faster-light/18650_Spot_Welder/Spot_Welder/Src/main.c

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

/* Includes ------------------------------------------------------------------*/
#include "main.h"

/* USER CODE BEGIN Includes */

#include "ssd1306.h"
#include "fonts.h"


/* USER CODE END Includes */

I2C_HandleTypeDef hi2c1;

TIM_HandleTypeDef htim1;
TIM_HandleTypeDef htim2;

void SystemClock_Config(void);
static void MX_GPIO_Init(void);
static void MX_I2C1_Init(void);
static void MX_TIM1_Init(void);
static void MX_TIM2_Init(void);
/* USER CODE BEGIN 0 */

int zero_detect_flag = 0;								// Флаг прерывания детектора нуля
int zero_detect_flag_status = 0;				// Флаг прерываня в таймере 500 мс

char str[10];														// Буфер для отображения скважности и времени
char str2[10];

int encoder_A = 0;											// Переменная для обработки энкодера

int display_change_flag = 1;						// Флаг изменений	на дисплее
int select_value_by_encoder = 0;				// Выбор меню

int fire_flag = 0;											// Флаг сварки (включает число оставшихся циклов сварки)

int duty_cycle = 70;										// Скважность
int duration = 10;											// Продолжительность (Циклов сварки)


/*Callback по сравнению таймера (от 1.0 до 9.0 мс)*/
/*! �?спользуется режим "One Pulse Mode" В этом режиме таймер отключается после первого срабатывания до
Counter Period и его снова можно начинать*/

void HAL_TIM_OC_DelayElapsedCallback(TIM_HandleTypeDef *htim)
{
        if(htim->Instance == TIM1)
        {
            HAL_GPIO_WritePin(GPIOB, GPIO_PIN_0, GPIO_PIN_RESET);
//						HAL_TIM_OC_Stop_IT(&htim1, TIM_CHANNEL_1);
        }
				
}

// Перевод int to char[]

#include <string.h>
 
 void reverse(char s[])
 {
     int i, j;
     char c;
 
     for (i = 0, j = strlen(s)-1; i<j; i++, j--) {
         c = s[i];
         s[i] = s[j];
         s[j] = c;
     }
 }

 void itoa(int n, char s[])
 {
     int i, sign;
 
     if ((sign = n) < 0) 
         n = -n;         
     i = 0;
     do {  
         s[i++] = n % 10 + '0';  
     } while ((n /= 10) > 0);    
     if (sign < 0)
         s[i++] = '-';
     s[i] = '\0';
     reverse(s);
 }
 
 // Функция обновления дисплея. Находится в бесконечном цикле, срабатывает при правильном флаге
 void display_update() {
	
		if (display_change_flag == 1) {
		
		display_change_flag = 0;
			
		itoa(duration, str);
		itoa(duty_cycle, str2);
			
		ssd1306_Fill(Black);
			
		if (select_value_by_encoder == 0) {
			ssd1306_DrawPixel(120, 4, White);
			ssd1306_DrawPixel(121, 4, White);
			ssd1306_DrawPixel(119, 4, White);
			ssd1306_DrawPixel(120, 3, White);
			ssd1306_DrawPixel(120, 5, White);
		} else {
			ssd1306_DrawPixel(120, 13, White);
			ssd1306_DrawPixel(121, 13, White);
			ssd1306_DrawPixel(119, 13, White);
			ssd1306_DrawPixel(120, 12, White);
			ssd1306_DrawPixel(120, 14, White);
		}
			
		ssd1306_SetCursor(5,0);	
		ssd1306_WriteString("Time: ", Font_7x10, White);	

		ssd1306_SetCursor(40,0);		
		ssd1306_WriteString(str, Font_7x10, White);	

		if (duration < 10) {
			ssd1306_SetCursor(48,0);		
			ssd1306_WriteString("ms", Font_7x10, White);			
		}
			
		if ((duration > 9) && (duration < 100)) {
			ssd1306_SetCursor(56,0);		
			ssd1306_WriteString("ms", Font_7x10, White);		
		}			
			
		if (duration > 99) {
			ssd1306_SetCursor(64,0);		
			ssd1306_WriteString("ms", Font_7x10, White);
		}			
			
		ssd1306_SetCursor(5,10);	
		ssd1306_WriteString("Duty cycle:", Font_7x10, White);	
		
		ssd1306_SetCursor(82,10);		
		ssd1306_WriteString(str2, Font_7x10, White);	
		
		if (duty_cycle == 100) {
			ssd1306_SetCursor(106,10);	
			ssd1306_WriteString("%", Font_7x10, White);			
		} else {
			ssd1306_SetCursor(98,10);	
			ssd1306_WriteString("%", Font_7x10, White);			
		}
		
		if (zero_detect_flag_status == 0) {
			
		ssd1306_SetCursor(20,21);	
		ssd1306_WriteString("-NO PULSES-", Font_7x10, White);		
		}


		ssd1306_UpdateScreen();  
			
		}
}
 

// Callback по переполнению таймера (500 мс) для отслеживания нуля
void HAL_TIM_PeriodElapsedCallback(TIM_HandleTypeDef *htim) {
    if(htim->Instance == TIM2) {
			
				if (zero_detect_flag == 1) {
					zero_detect_flag_status = 1;
				} else {
					zero_detect_flag_status = 0;
					fire_flag = 0;
				}
				
				
				zero_detect_flag = 0;
    display_change_flag = 1;
		}
}

/* USER CODE END 0 */

/**
  * @brief  The application entry point.
  * @retval int
  */
int main(void)
{
  /* MCU Configuration--------------------------------------------------------*/

  /* Reset of all peripherals, Initializes the Flash interface and the Systick. */
  HAL_Init();

  /* Configure the system clock */
  SystemClock_Config();

  /* Initialize all configured peripherals */
  MX_GPIO_Init();
  MX_I2C1_Init();
  MX_TIM1_Init();
  MX_TIM2_Init();
  /* USER CODE BEGIN 2 */

	HAL_TIM_Base_Start_IT(&htim2);

	ssd1306_Init();

  ssd1306_UpdateScreen();



  /* USER CODE END 2 */

  /* Infinite loop */
  /* USER CODE BEGIN WHILE */
  while (1)
  {
			
	display_update();

    /* USER CODE END WHILE */

    /* USER CODE BEGIN 3 */
  }
  /* USER CODE END 3 */
}

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
/* USER CODE BEGIN 4 */

int led_state = 0;


void HAL_GPIO_EXTI_Callback(uint16_t GPIO_Pin)

{

	// Обработка прерывания по FALLING PA2 - Кнопка энкодера
	
  if (GPIO_Pin == GPIO_PIN_2) {
		  
	display_change_flag = 1;
		
	if (select_value_by_encoder == 0) {
		select_value_by_encoder = 1;
	} else 
	select_value_by_encoder = 0;
			
  } else {
		
    __NOP();

  }
	
	// Обработка прерывания по FALLING PA1 - Поворот энкодера
	
	if (GPIO_Pin == GPIO_PIN_1) {
		encoder_A++;
		
		if (select_value_by_encoder == 0) {
			if (HAL_GPIO_ReadPin(GPIOA, GPIO_PIN_3)) {
				
				if (duration > 10)
						duration = duration - 10;
					
			} else {
				
					if (duration < 990)
						duration = duration + 10;		
					
			}		
			
		} else {
		
			if (HAL_GPIO_ReadPin(GPIOA, GPIO_PIN_3)) {
				if (duty_cycle > 10)
				duty_cycle = duty_cycle - 5;
			} else {
				if (duty_cycle < 90)
				duty_cycle = duty_cycle + 5;
			}
		
		}
		
	display_change_flag = 1;		
		
	} else {

    __NOP();

  }
	
	// Обработка прерывания по FALLING PA10 - Детектор НУЛЯ
	
	if (GPIO_Pin == GPIO_PIN_10) {
		
		zero_detect_flag = 1;
		
		if (fire_flag > 0) {
		
			TIM1->CCR1 = duty_cycle;
		
			HAL_TIM_OC_Start_IT(&htim1, TIM_CHANNEL_1);
			HAL_GPIO_WritePin(GPIOB, GPIO_PIN_0, GPIO_PIN_SET);
			
			fire_flag--;
			
		}
		

		

		
	}	else {

    __NOP();

  }
	
	// Обработка прерывания по FALLING PB11 - Кнопка "сварки"
	
		if (GPIO_Pin == GPIO_PIN_11) {		

		display_change_flag = 1;
		fire_flag = duration / 10;


		
	}	else {

    __NOP();

  }
	
}



/* USER CODE END 4 */
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
