faster-light/18650_Spot_Welder/Spot_Welder/Spot_Welder.ioc

Mcu.UserName=STM32F103C8Tx
PA1.Signal=GPXTI1
PA10.Signal=GPXTI10
PA13.Signal=SYS_JTMS-SWDIO
PA14.Signal=SYS_JTCK-SWCLK
PA2.Signal=GPXTI2
PA3.Signal=GPIO_Input
PB0.Signal=GPIO_Output
PB11.Signal=GPXTI11
PB8.Signal=I2C1_SCL
PB9.Signal=I2C1_SDA
PC14-OSC32_IN.Signal=RCC_OSC32_IN
PC15-OSC32_OUT.Signal=RCC_OSC32_OUT
PD0-OSC_IN.Signal=RCC_OSC_IN
PD1-OSC_OUT.Signal=RCC_OSC_OUT
